nananek/rp2350-frisk/docs/pcb_bottom.png

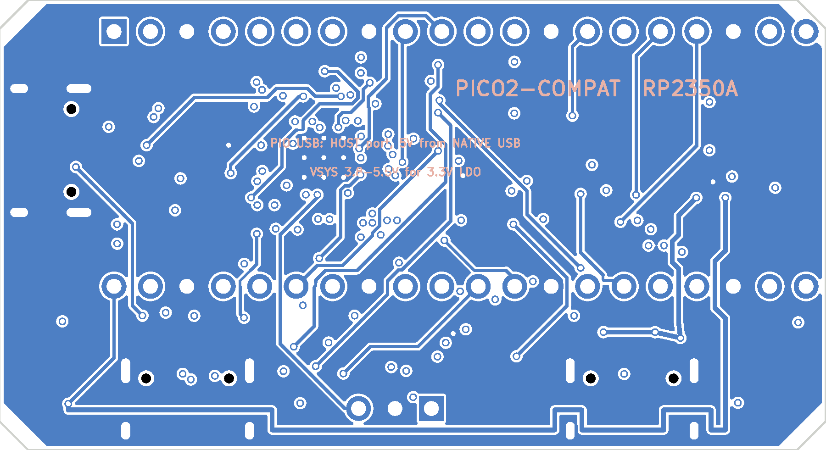
docs/pcb_bottom.png
