nananek/rp2350-frisk/docs/pcb_routing.png

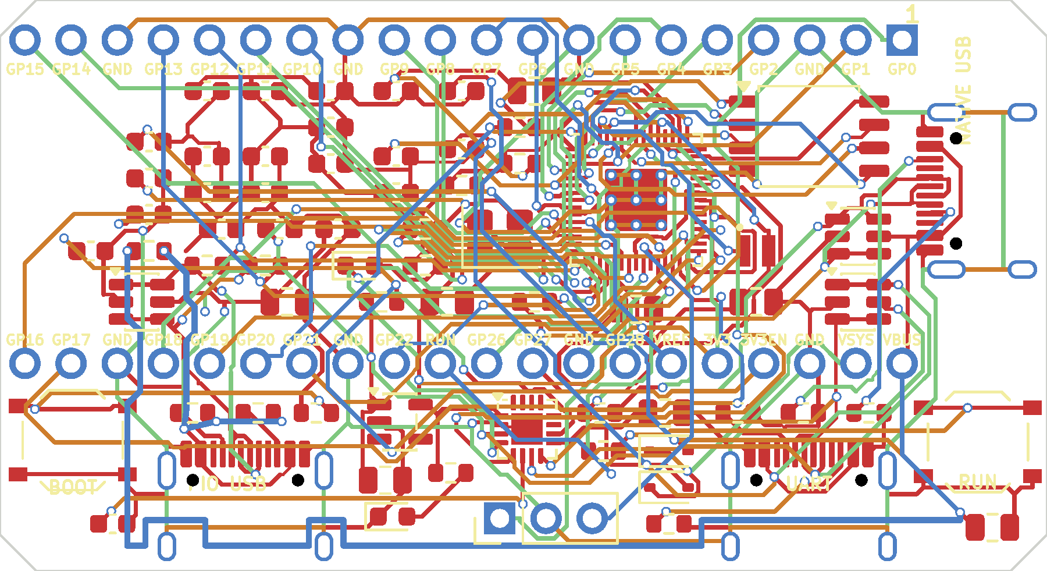
docs/pcb_routing.png
