nananek/rp2350-frisk/fab/bom_jlcpcb.csv

Comment | Designator | Footprint | LCSC Part #
RP2350A | U1 | RP2350-QFN-60-1EP_7x7_P0.4mm_EP3.4x3.4mm_ThermalVias | C42411118
W25Q32JVSSIQ | U2 | SOIC-8_5.3x5.3mm_P1.27mm | C179173
CH343P | U3 | QFN-16-1EP_3x3mm_P0.5mm_EP1.7x1.7mm | C2846043
AP2112K-3.3 | U4 | SOT-23-5 | C51118
TYPE-C-31-M-12 | J1,J2,J3 | USB_C_Receptacle_HRO_TYPE-C-31-M-12 | C165948
BAT54WS | D1,D3 | D_SOD-323 | C22629
USBLC6-2SC6 | D4,D5,D6 | SOT-23-6 | C7519
5.1k | R1,R2,R5,R6 | R_0603_1608Metric | C23186
56k | R3,R4 | R_0603_1608Metric | C23206
27 | R7,R8 | R_0603_1608Metric | C25190
22 | R9,R10 | R_0603_1608Metric | C23345
0 | R11,R14 | R_0603_1608Metric | C21189
1k | R12,R13,R18,R19,R20 | R_0603_1608Metric | C21190
33 | R15 | R_0603_1608Metric | C23140
200 | R16 | R_0603_1608Metric | C8218
100k | R17 | R_0603_1608Metric | C14675
3.3uH | L1 | L_pol_2016 | C42411119
ABM8-272-T3 | Y1 | Crystal_SMD_3225-4Pin_3.2x2.5mm | C20625731
BOOT | SW1 | SW_Push_1P1T_XKB_TS-1187A | C318884
RUN | SW2 | SW_Push_1P1T_XKB_TS-1187A | C318884
KT-0603R | LED1,LED2 | LED_0603_1608Metric | C2286
10uF | C1,C2,C3,C7,C9 | C_0805_2012Metric | C15850
100nF | C4,C5,C6,C8,C10,C12,C14,C15,C16,C17,C18,C19,C20,C21,C22,C23,C24,C27,C28,C29 | C_0603_1608Metric | C14663
4.7uF | C11,C13,C30 | C_0805_2012Metric | C1779
15pF | C25,C26 | C_0603_1608Metric | C1644
