nananek/rp2350-frisk/docs/schematic.pdf

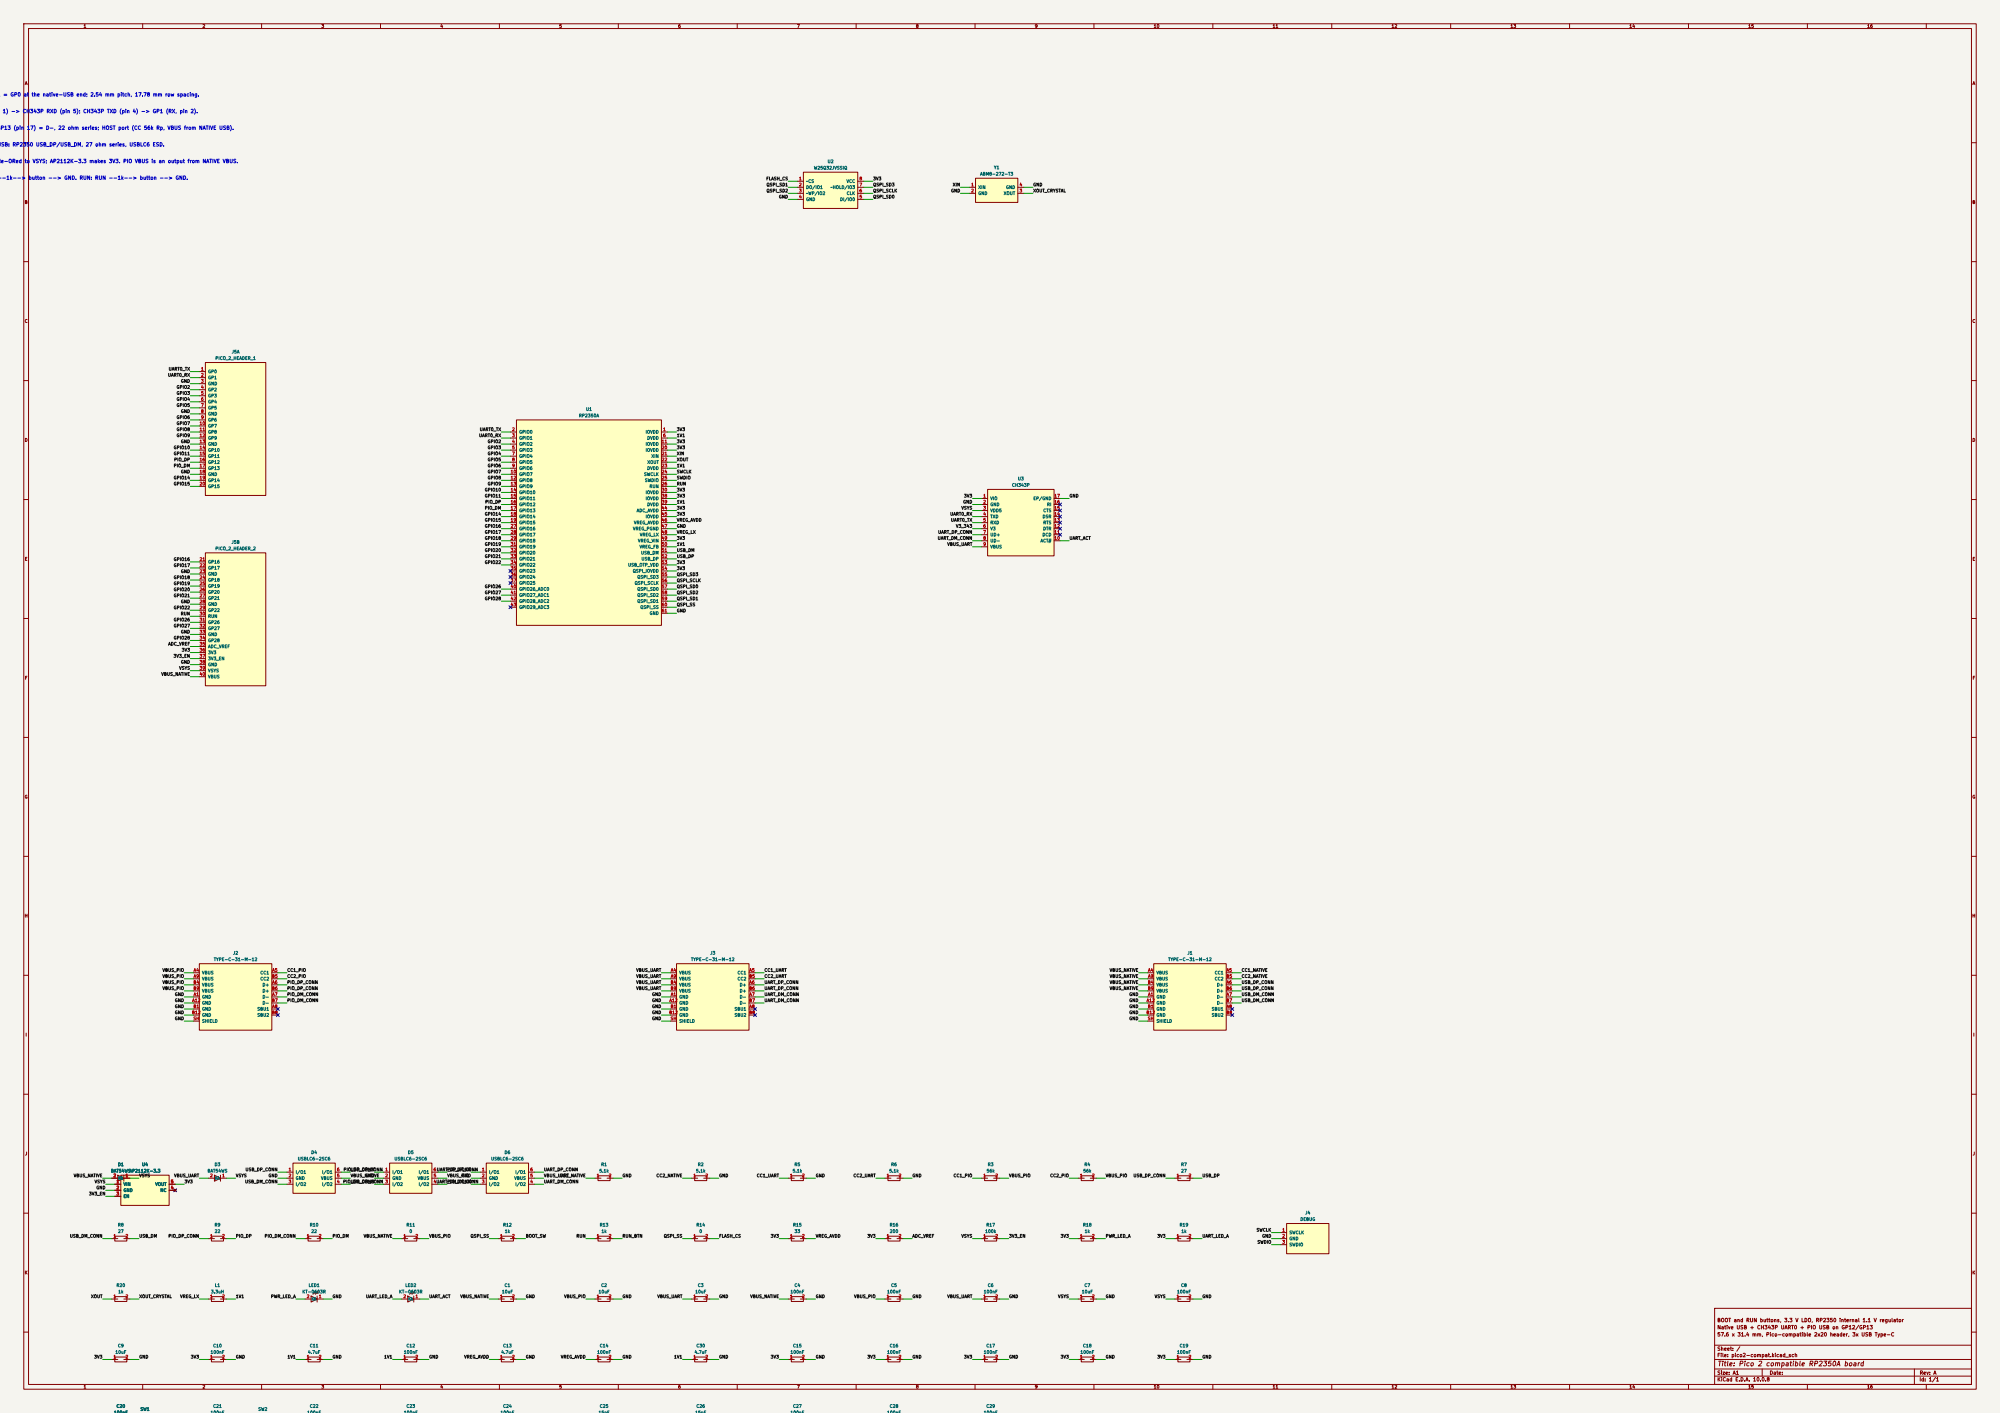
[picture p4: page 1]

Pico 2 header: pin 1 = GP0 at the native-USB end; 2.54 mm pitch, 17.78 mm row spacing.

UART0: GP0 (TX, pin 1) -> CH343P RXD (pin 5); CH343P TXD (pin 4) -> GP1 (RX, pin 2).

PIO USB: GP12 (pin 16) = D+, GP13 (pin 17) = D-, 22 ohm series; HOST port (CC 56k Rp, VBUS from NATIVE USB).

Native USB: RP2350 USB_DP/USB_DM, 27 ohm series, USBLC6 ESD.

Power: NATIVE/UART VBUS are diode-ORed to VSYS; AP2112K-3.3 makes 3V3. PIO VBUS is an output from NATIVE VBUS.

BOOT: QSPI_SS --1k--> button --> GND. RUN: RUN --1k--> button --> GND.

Native USB + CH343P UART0 + PIO USB on GP12/GP13
57.6 x 31.4 mm, Pico-compatible 2x20 header, 3x USB Type-C

Sheet: /
File: pico2-compat.kicad_sch
Title: Pico 2 compatible RP2350A board

Size: A1 | Rev: A
KiCad E.D.A. 10.0.8 | Id: 1/1
