nananek/rp2350-frisk/pico2-compat.kicad_pcb

## KiCad design pico2-compat.kicad_pcb (2026-11-09)

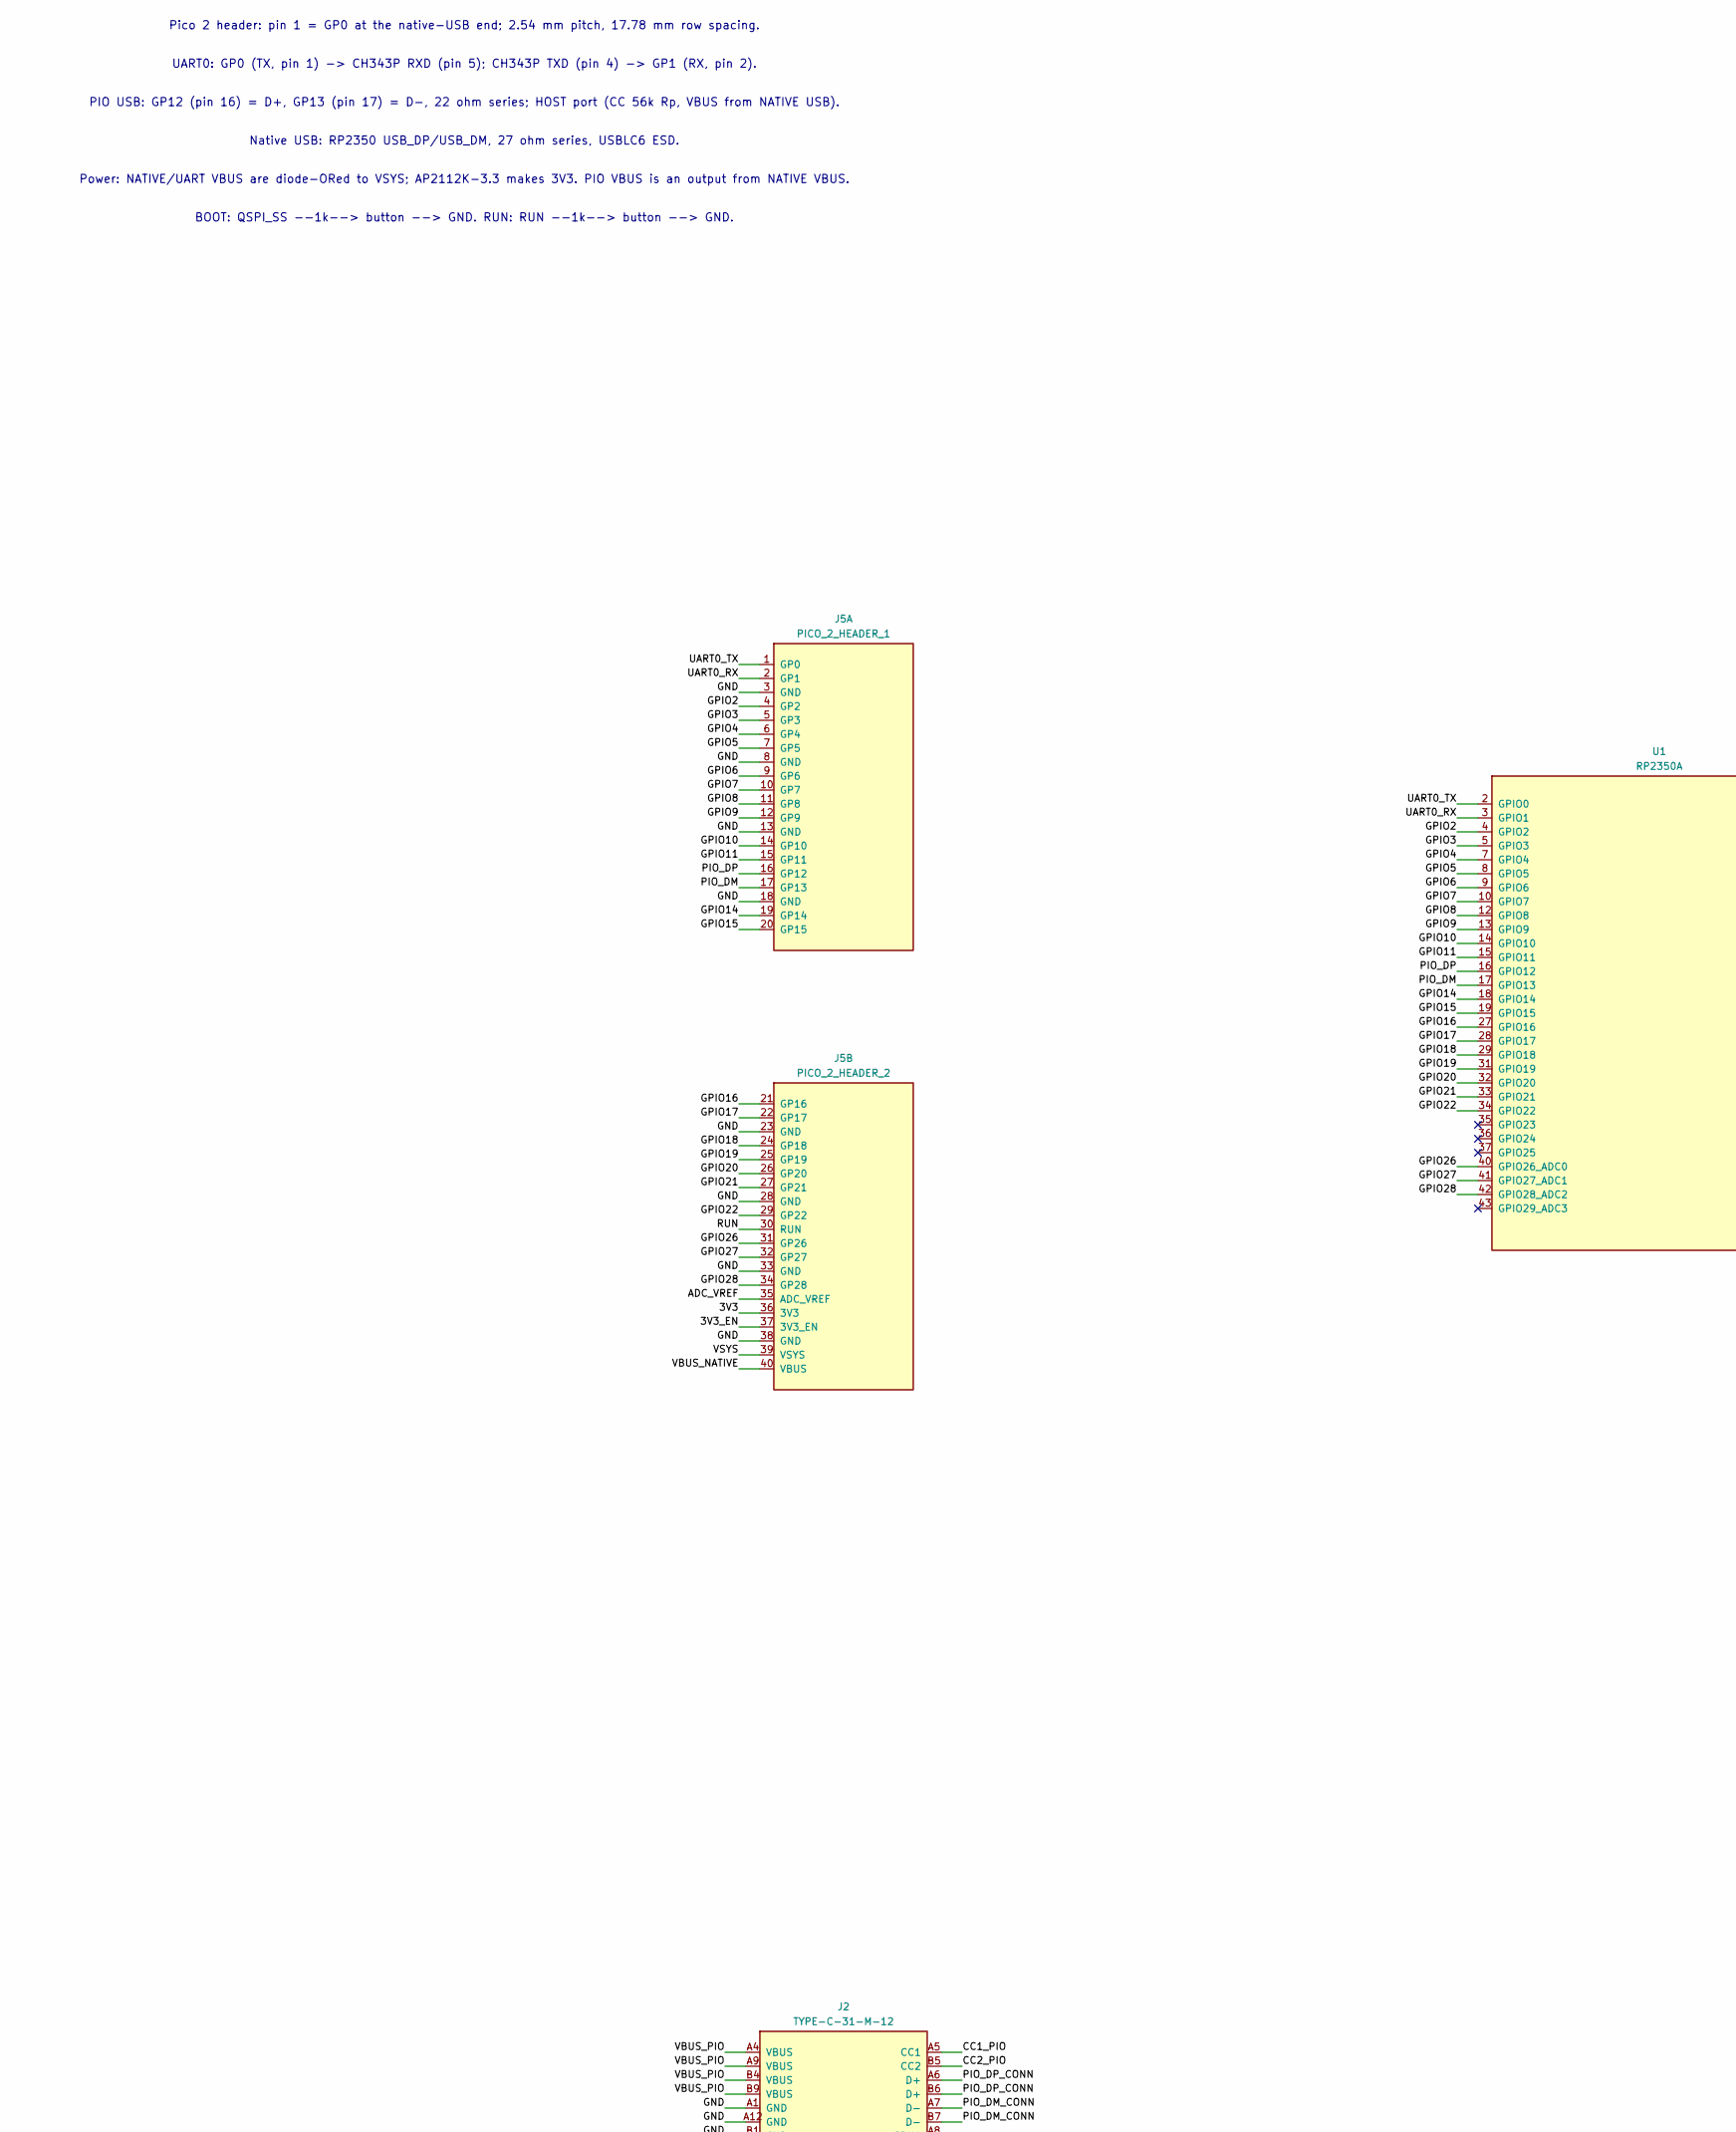
[picture p5: schematic pico2-compat.kicad_sch, Pico 2 compatible RP2350A board, part in row 1, column 1]

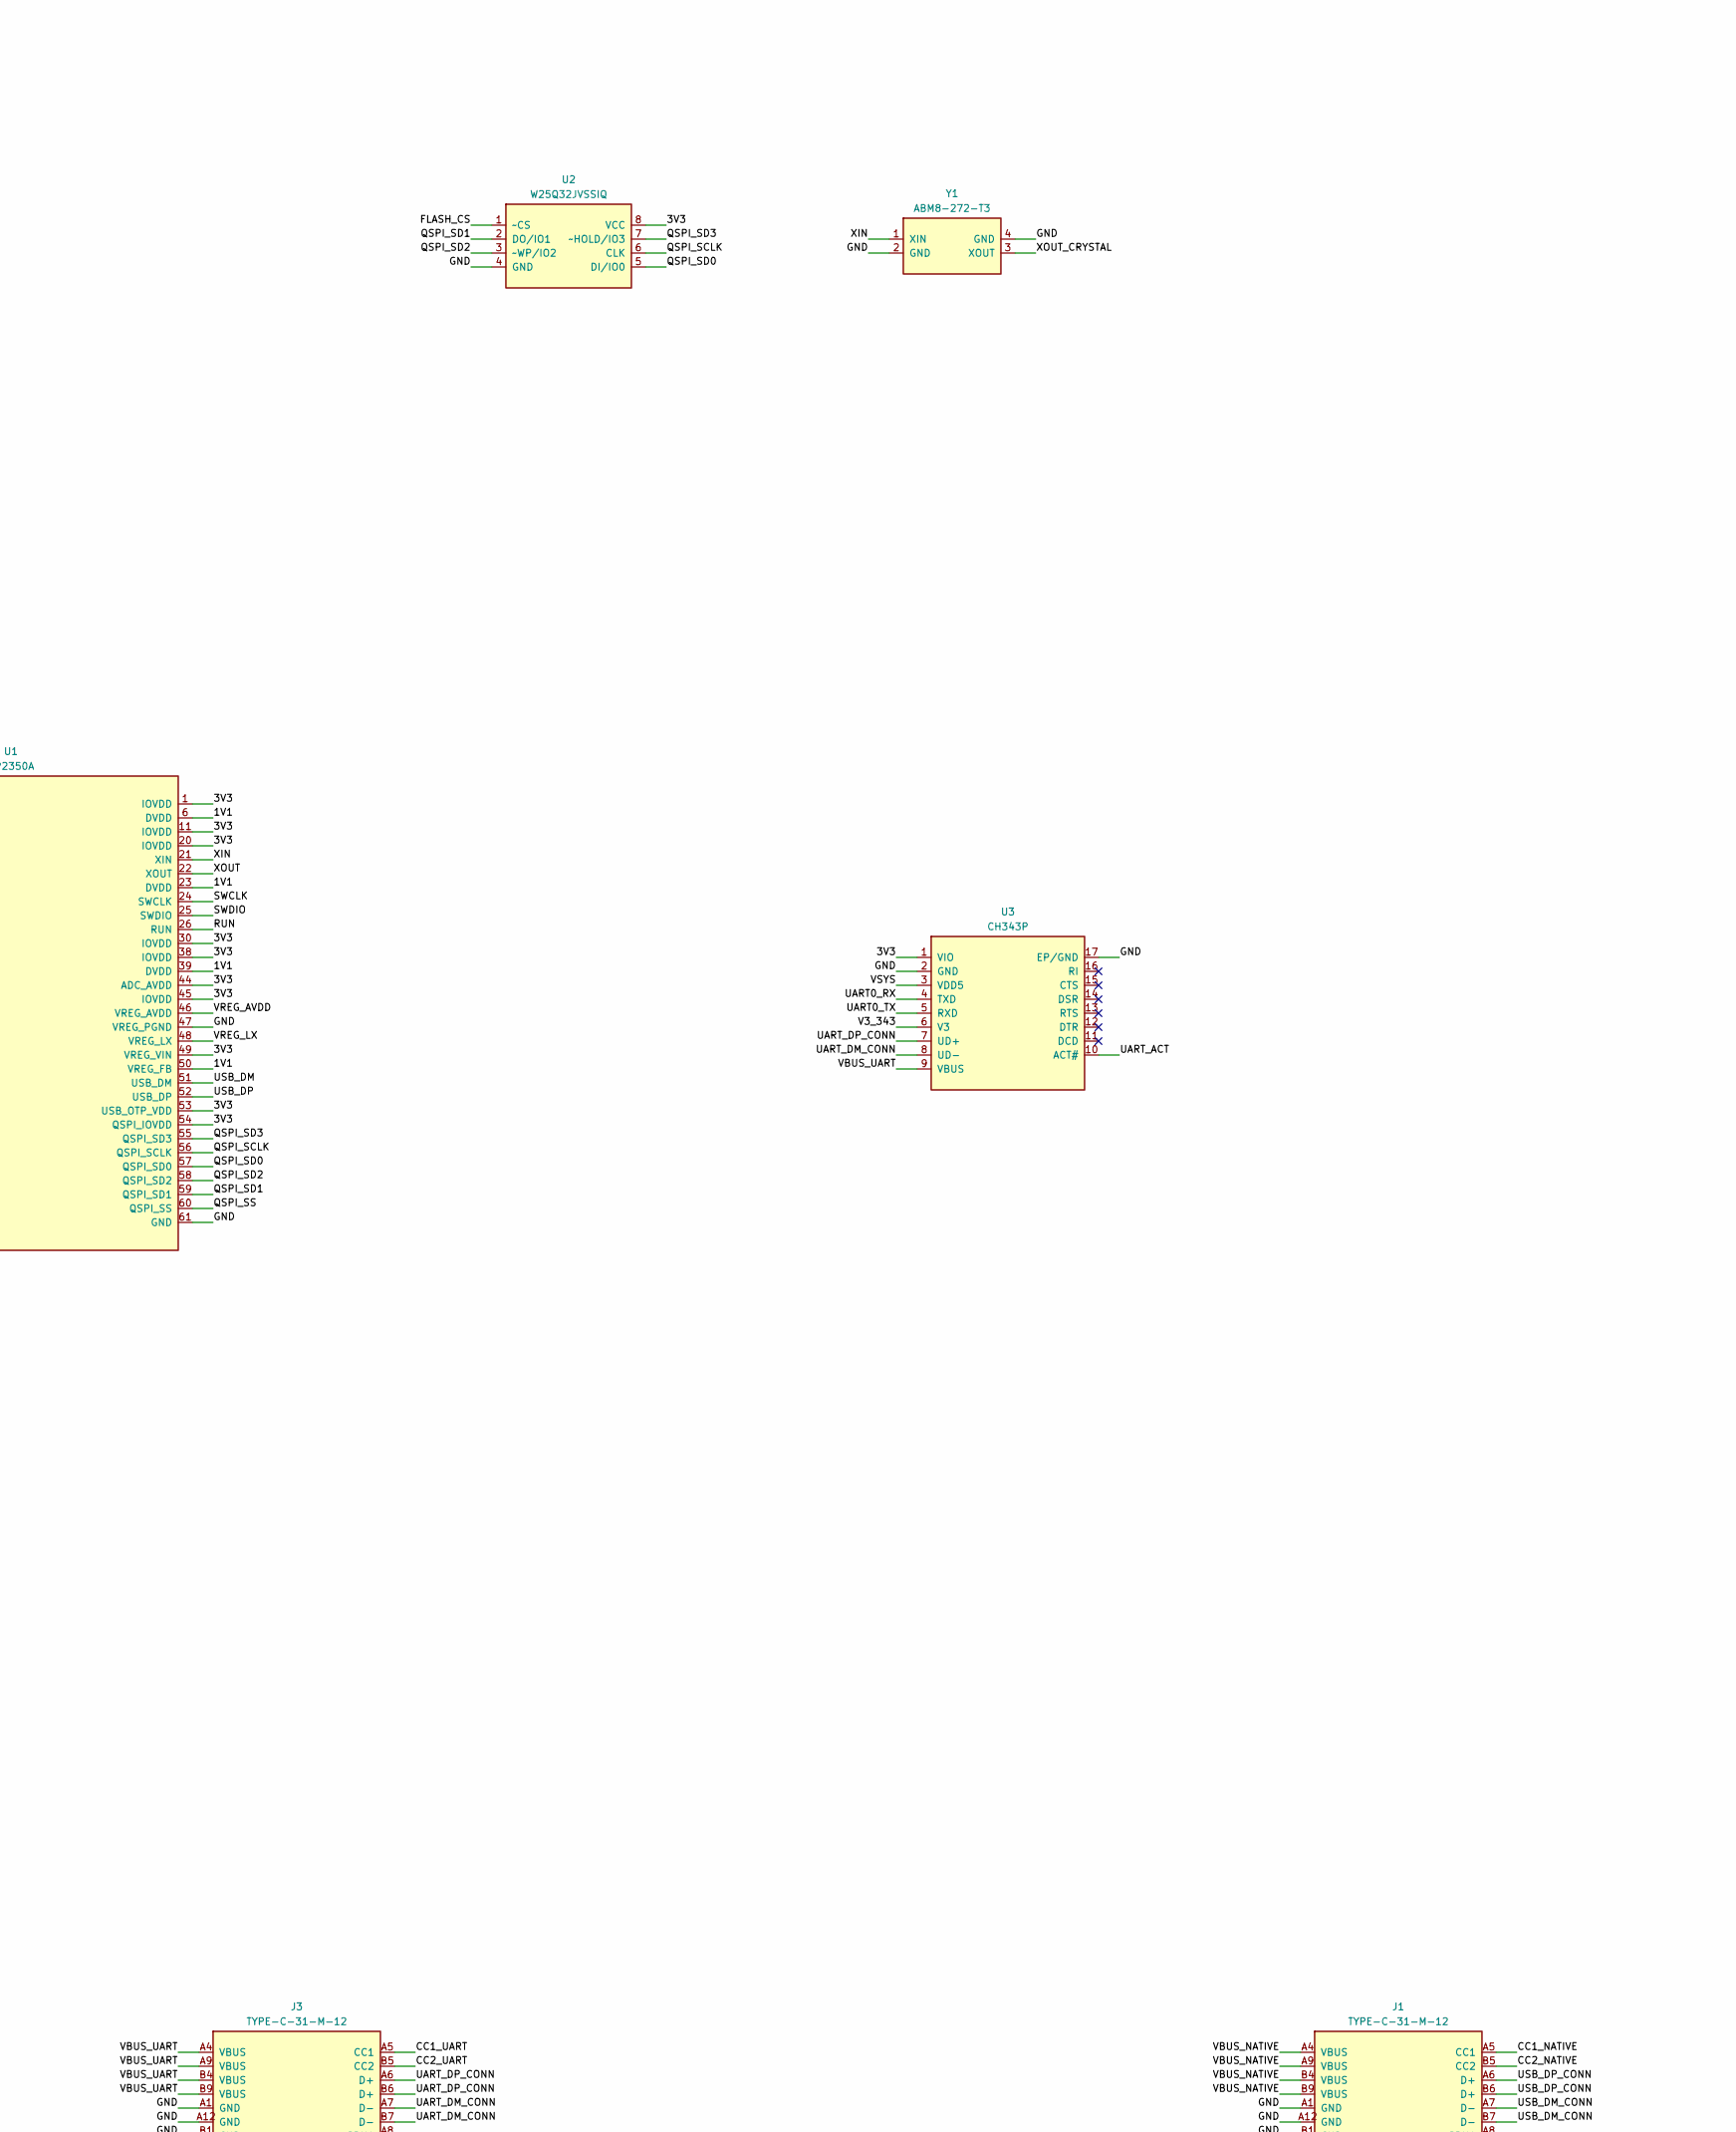
[picture p6: schematic pico2-compat.kicad_sch, Pico 2 compatible RP2350A board, part in row 1, column 2]

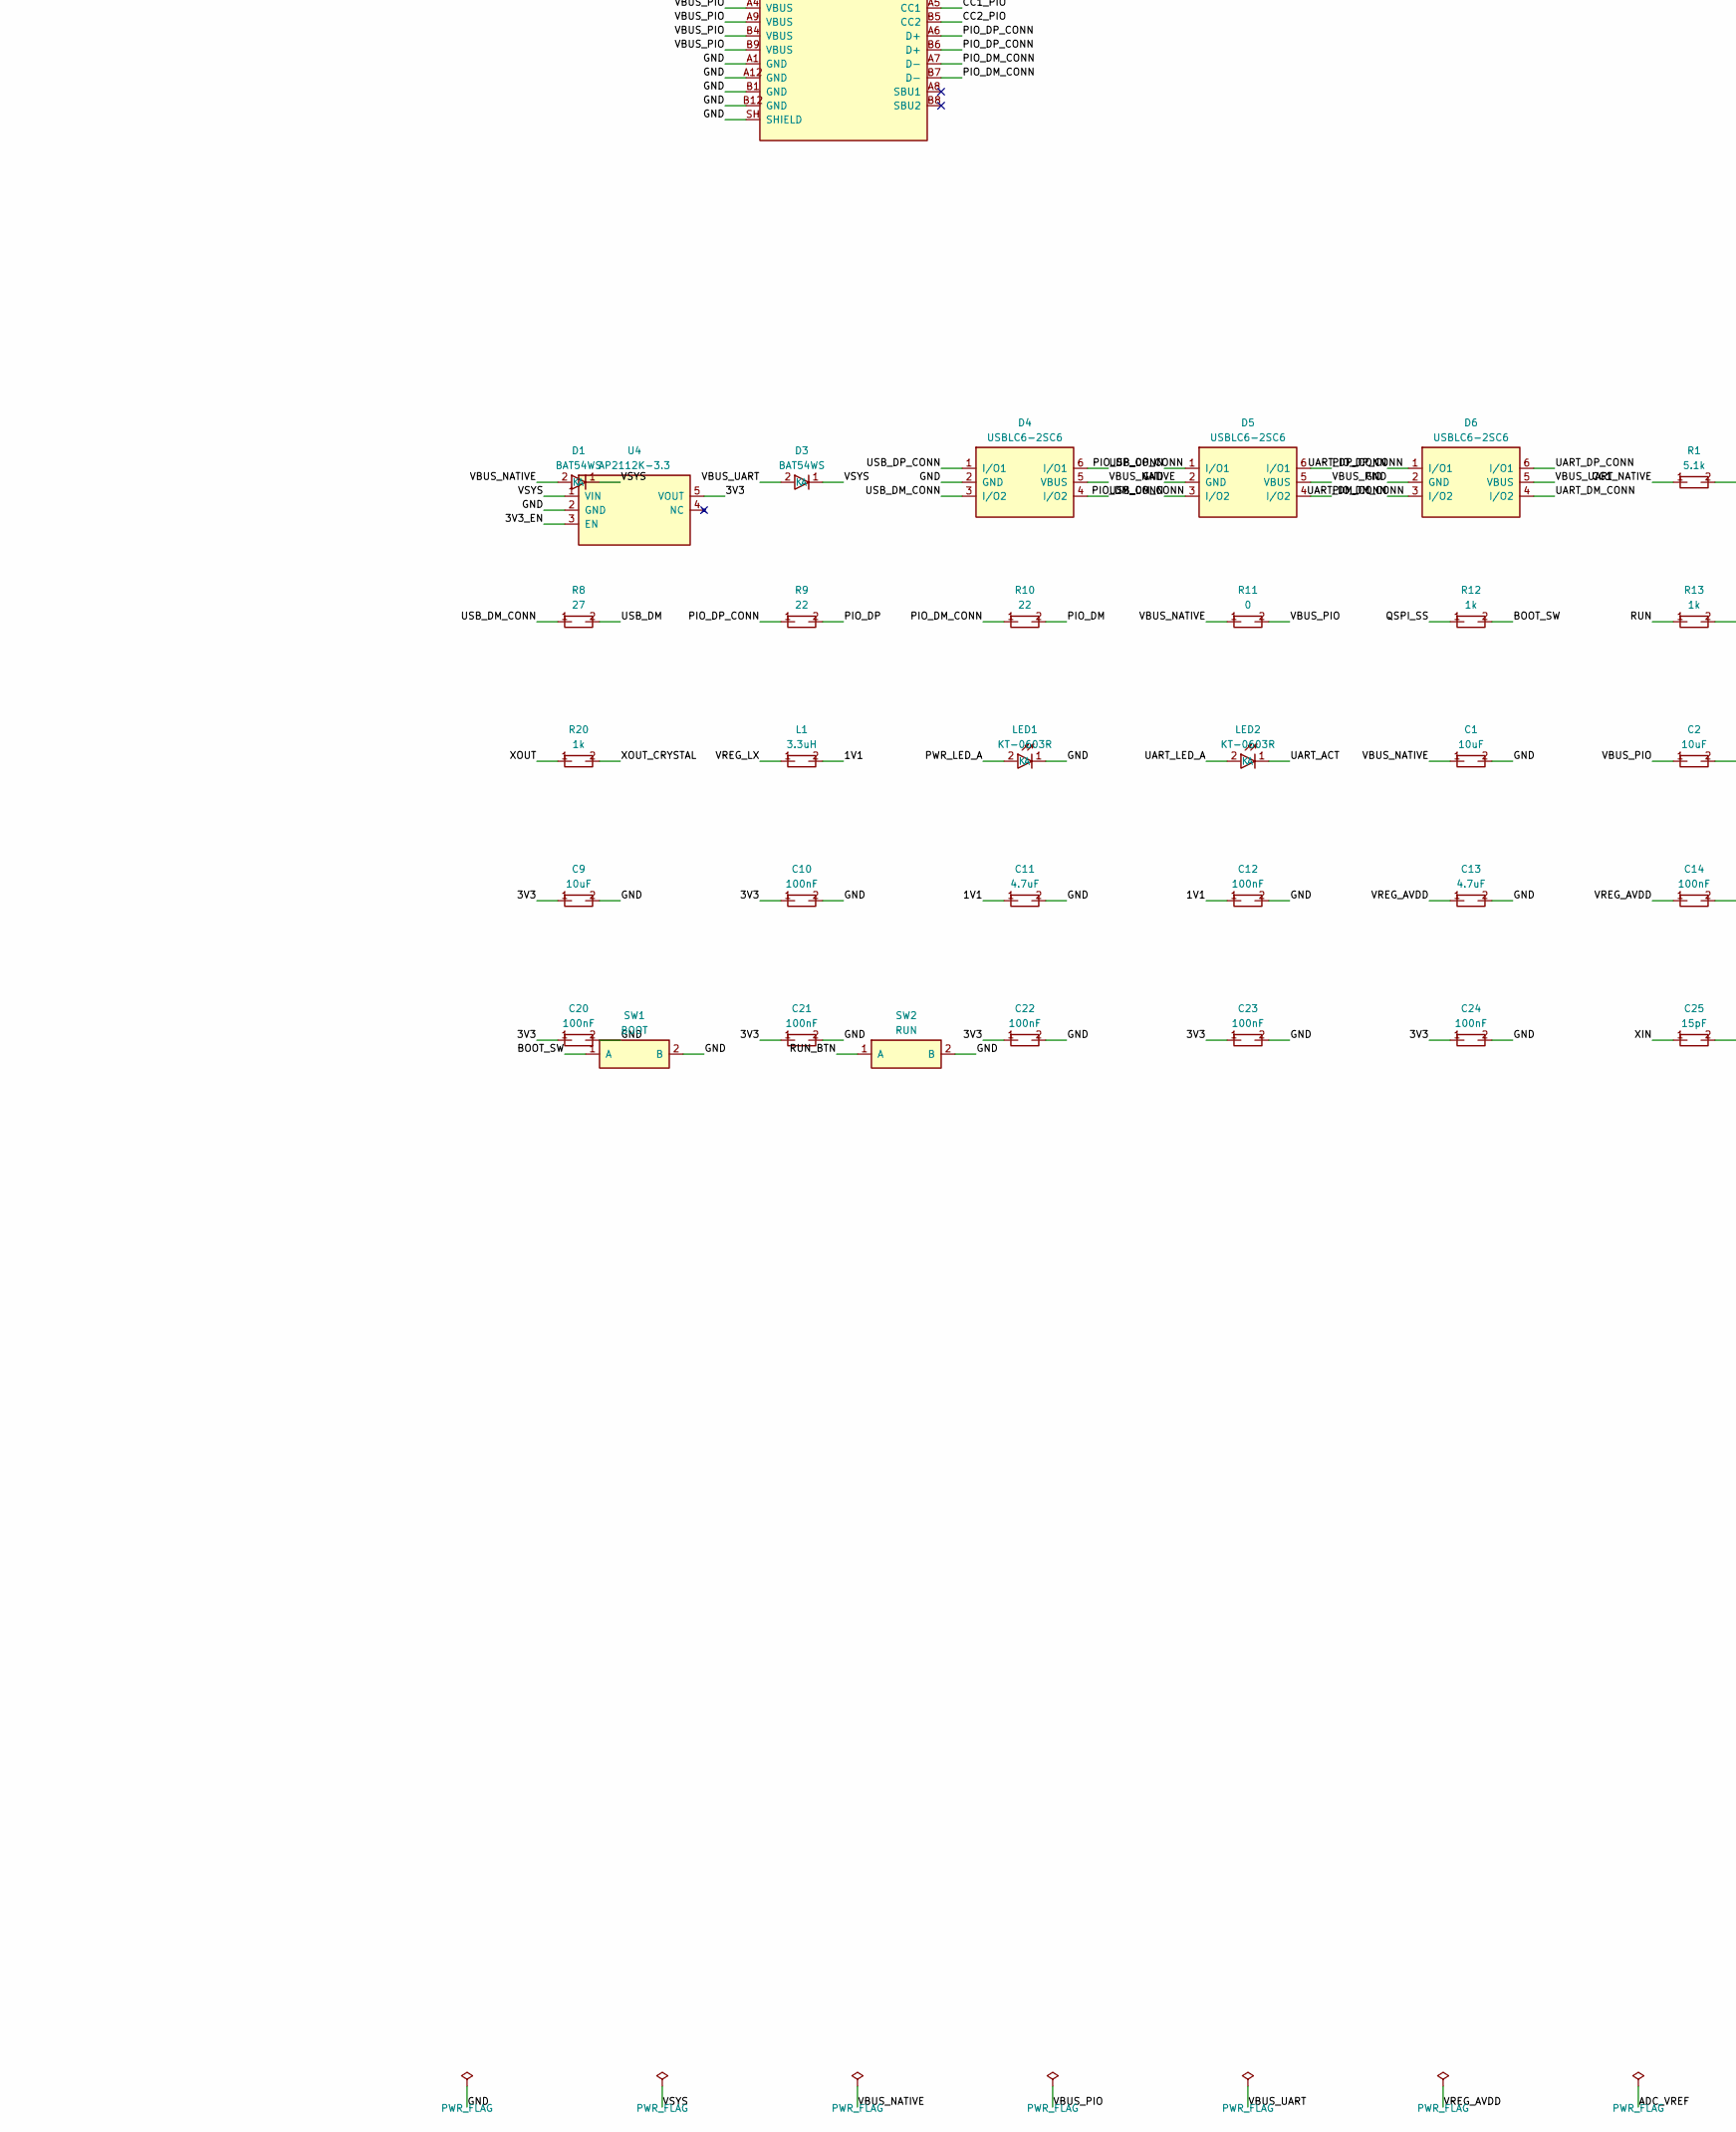
[picture p7: schematic pico2-compat.kicad_sch, Pico 2 compatible RP2350A board, part in row 2, column 1]

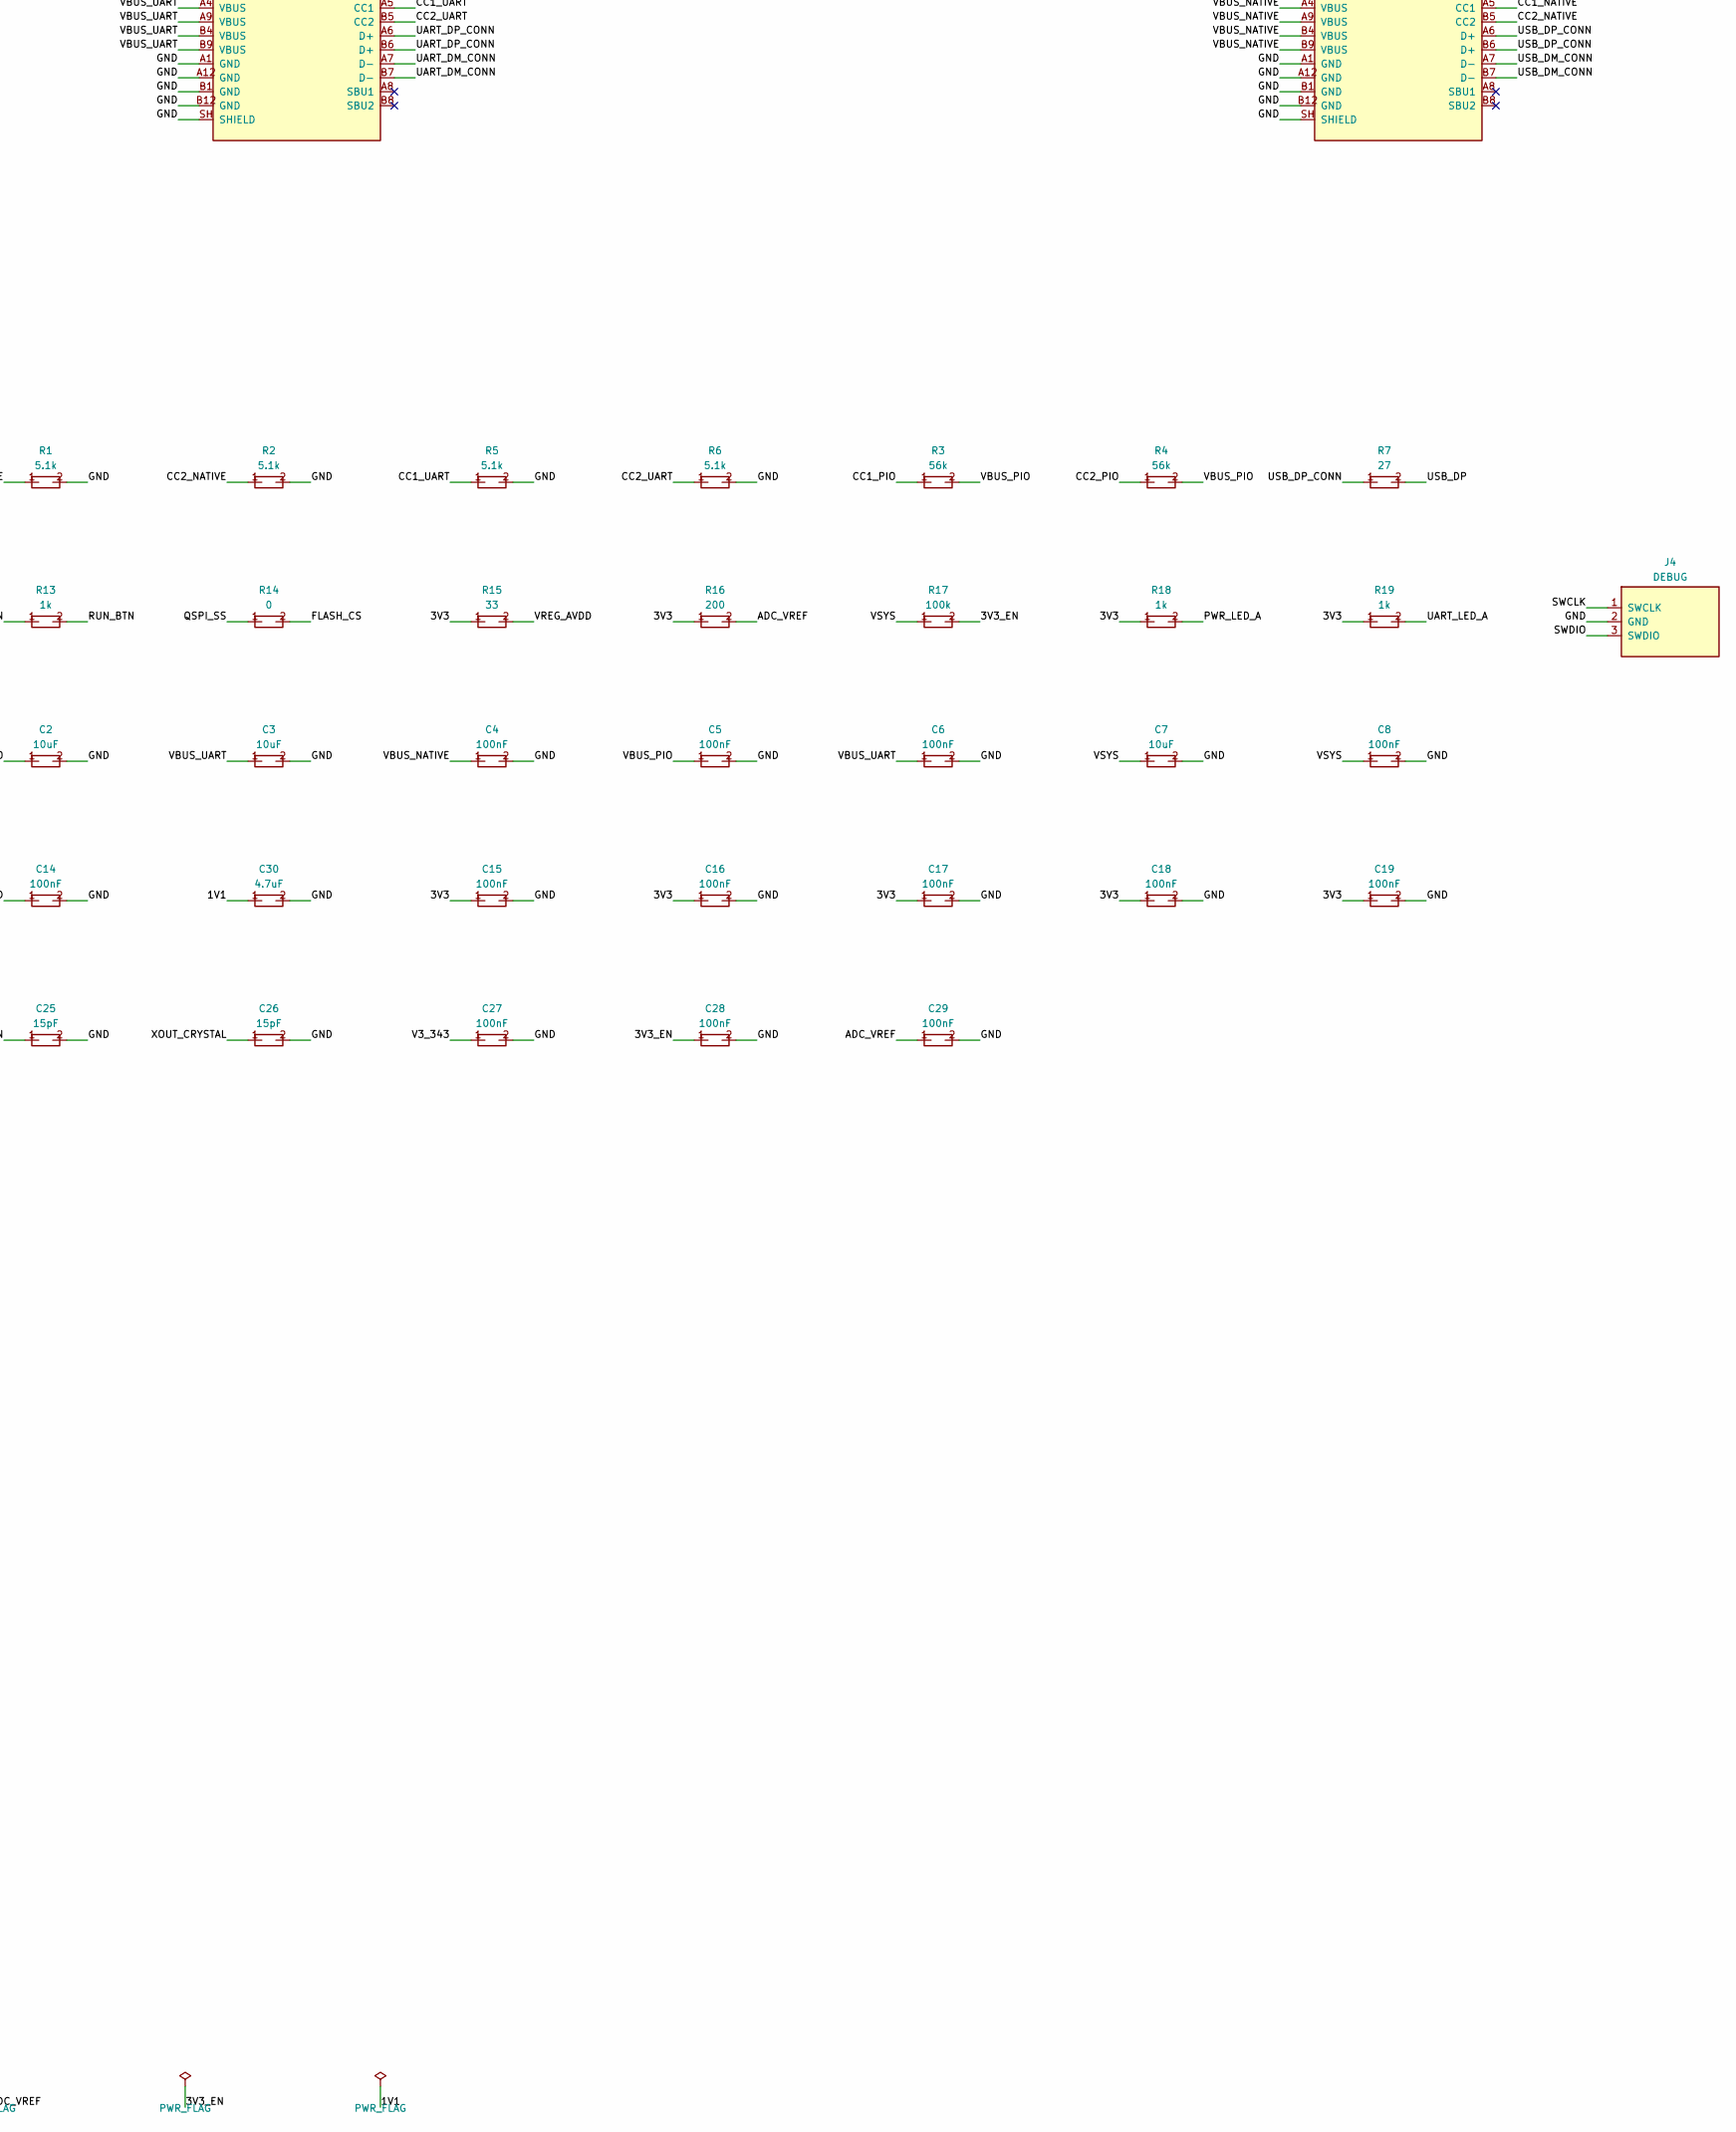
[picture p8: schematic pico2-compat.kicad_sch, Pico 2 compatible RP2350A board, part in row 2, column 2]

Parts:
C1, C2, C3, C7, C9: 10uF; C_0805_2012Metric; LCSC C15850
C4, C5, C6, C8, C10, C12, C14, C15, C16, C17, C18, C19, C20, C21, C22, C23, C24, C27, C28, C29: 100nF; C_0603_1608Metric; LCSC C14663
C11, C13, C30: 4.7uF; C_0805_2012Metric; LCSC C1779
C25, C26: 15pF; C_0603_1608Metric; LCSC C1644
D1, D3: BAT54WS; D_SOD-323; LCSC C22629
D4, D5, D6: USBLC6-2SC6; SOT-23-6; LCSC C7519
J1, J2, J3: TYPE-C-31-M-12; USB_C_Receptacle_HRO_TYPE-C-31-M-12; LCSC C165948
J4: DEBUG; PinHeader_1x03_P2.54mm_Vertical
J5A: PICO_2_HEADER_1; PinHeader_1x20_Pico_Top
J5B: PICO_2_HEADER_2; PinHeader_1x20_Pico_Bottom
L1: 3.3uH; L_pol_2016; LCSC C42411119
LED1, LED2: KT-0603R; LED_0603_1608Metric; LCSC C2286
R1, R2, R5, R6: 5.1k; R_0603_1608Metric; LCSC C23186
R3, R4: 56k; R_0603_1608Metric; LCSC C23206
R7, R8: 27; R_0603_1608Metric; LCSC C25190
R9, R10: 22; R_0603_1608Metric; LCSC C23345
R11, R14: 0; R_0603_1608Metric; LCSC C21189
R12, R13, R18, R19, R20: 1k; R_0603_1608Metric; LCSC C21190
R15: 33; R_0603_1608Metric; LCSC C23140
R16: 200; R_0603_1608Metric; LCSC C8218
R17: 100k; R_0603_1608Metric; LCSC C14675
SW1: BOOT; SW_Push_1P1T_XKB_TS-1187A; LCSC C318884
SW2: RUN; SW_Push_1P1T_XKB_TS-1187A; LCSC C318884
U1: RP2350A; RP2350-QFN-60-1EP_7x7_P0.4mm_EP3.4x3.4mm_ThermalVias; LCSC C42411118
U2: W25Q32JVSSIQ; SOIC-8_5.3x5.3mm_P1.27mm; LCSC C179173
U3: CH343P; QFN-16-1EP_3x3mm_P0.5mm_EP1.7x1.7mm; LCSC C2846043
U4: AP2112K-3.3; SOT-23-5; LCSC C51118
Y1: ABM8-272-T3; Crystal_SMD_3225-4Pin_3.2x2.5mm; LCSC C20625731

Connections:
1V1: C11.1, C12.1, C30.1, L1.2, U1.6 (DVDD), U1.23 (DVDD), U1.39 (DVDD), U1.50 (VREG_FB)
3V3: C9.1, C10.1, C15.1, C16.1, C17.1, C18.1, C19.1, C20.1, C21.1, C22.1, C23.1, C24.1, J5B.36 (3V3), R15.1, R16.1, R18.1, R19.1, U1.1 (IOVDD), U1.11 (IOVDD), U1.20 (IOVDD), U1.30 (IOVDD), U1.38 (IOVDD), U1.44 (ADC_AVDD), U1.45 (IOVDD), U1.49 (VREG_VIN), U1.53 (USB_OTP_VDD), U1.54 (QSPI_IOVDD), U2.8 (VCC), U3.1 (VIO), U4.5 (VOUT)
3V3_EN: C28.1, J5B.37 (3V3_EN), R17.2, U4.3 (EN)
ADC_VREF: C29.1, J5B.35 (ADC_VREF), R16.2
BOOT_SW: R12.2, SW1.1 (A)
CC1_NATIVE: J1.A5 (CC1), R1.1
CC1_PIO: J2.A5 (CC1), R3.1
CC1_UART: J3.A5 (CC1), R5.1
CC2_NATIVE: J1.B5 (CC2), R2.1
CC2_PIO: J2.B5 (CC2), R4.1
CC2_UART: J3.B5 (CC2), R6.1
FLASH_CS: R14.2, U2.1 (~CS)
GND: C1.2, C2.2, C3.2, C4.2, C5.2, C6.2, C7.2, C8.2, C9.2, C10.2, C11.2, C12.2, C13.2, C14.2, C15.2, C16.2, C17.2, C18.2, C19.2, C20.2, C21.2, C22.2, C23.2, C24.2, C25.2, C26.2, C27.2, C28.2, C29.2, C30.2, D4.2 (GND), D5.2 (GND), D6.2 (GND), J1.A1 (GND), J1.A12 (GND), J1.B1 (GND), J1.B12 (GND), J1.SH (SHIELD), J2.A1 (GND), J2.A12 (GND), J2.B1 (GND), J2.B12 (GND), J2.SH (SHIELD), J3.A1 (GND), J3.A12 (GND), J3.B1 (GND), J3.B12 (GND), J3.SH (SHIELD), J4.2 (GND), J5A.3 (GND), J5A.8 (GND), J5A.13 (GND), J5A.18 (GND), J5B.23 (GND), J5B.28 (GND), J5B.33 (GND), J5B.38 (GND), LED1.1 (K), R1.2, R2.2, R5.2, R6.2, SW1.2 (B), SW2.2 (B), U1.47 (VREG_PGND), U1.61 (GND), U2.4 (GND), U3.2 (GND), U3.17 (EP/GND), U4.2 (GND), Y1.2 (GND), Y1.4 (GND)
GPIO2: J5A.4 (GP2), U1.4 (GPIO2)
GPIO3: J5A.5 (GP3), U1.5 (GPIO3)
GPIO4: J5A.6 (GP4), U1.7 (GPIO4)
GPIO5: J5A.7 (GP5), U1.8 (GPIO5)
GPIO6: J5A.9 (GP6), U1.9 (GPIO6)
GPIO7: J5A.10 (GP7), U1.10 (GPIO7)
GPIO8: J5A.11 (GP8), U1.12 (GPIO8)
GPIO9: J5A.12 (GP9), U1.13 (GPIO9)
GPIO10: J5A.14 (GP10), U1.14 (GPIO10)
GPIO11: J5A.15 (GP11), U1.15 (GPIO11)
GPIO14: J5A.19 (GP14), U1.18 (GPIO14)
GPIO15: J5A.20 (GP15), U1.19 (GPIO15)
GPIO16: J5B.21 (GP16), U1.27 (GPIO16)
GPIO17: J5B.22 (GP17), U1.28 (GPIO17)
GPIO18: J5B.24 (GP18), U1.29 (GPIO18)
GPIO19: J5B.25 (GP19), U1.31 (GPIO19)
GPIO20: J5B.26 (GP20), U1.32 (GPIO20)
GPIO21: J5B.27 (GP21), U1.33 (GPIO21)
GPIO22: J5B.29 (GP22), U1.34 (GPIO22)
GPIO26: J5B.31 (GP26), U1.40 (GPIO26_ADC0)
GPIO27: J5B.32 (GP27), U1.41 (GPIO27_ADC1)
GPIO28: J5B.34 (GP28), U1.42 (GPIO28_ADC2)
PIO_DM: J5A.17 (GP13), R10.2, U1.17 (GPIO13)
PIO_DM_CONN: D5.3 (I/O2), D5.4 (I/O2), J2.A7 (D-), J2.B7 (D-), R10.1
PIO_DP: J5A.16 (GP12), R9.2, U1.16 (GPIO12)
PIO_DP_CONN: D5.1 (I/O1), D5.6 (I/O1), J2.A6 (D+), J2.B6 (D+), R9.1
PWR_LED_A: LED1.2 (A), R18.2
QSPI_SCLK: U1.56 (QSPI_SCLK), U2.6 (CLK)
QSPI_SD0: U1.57 (QSPI_SD0), U2.5 (DI/IO0)
QSPI_SD1: U1.59 (QSPI_SD1), U2.2 (DO/IO1)
QSPI_SD2: U1.58 (QSPI_SD2), U2.3 (~WP/IO2)
QSPI_SD3: U1.55 (QSPI_SD3), U2.7 (~HOLD/IO3)
QSPI_SS: R12.1, R14.1, U1.60 (QSPI_SS)
RUN: J5B.30 (RUN), R13.1, U1.26 (RUN)
RUN_BTN: R13.2, SW2.1 (A)
SWCLK: J4.1 (SWCLK), U1.24 (SWCLK)
SWDIO: J4.3 (SWDIO), U1.25 (SWDIO)
UART0_RX: J5A.2 (GP1), U1.3 (GPIO1), U3.4 (TXD)
UART0_TX: J5A.1 (GP0), U1.2 (GPIO0), U3.5 (RXD)
UART_ACT: LED2.1 (K), U3.10 (ACT#)
UART_DM_CONN: D6.3 (I/O2), D6.4 (I/O2), J3.A7 (D-), J3.B7 (D-), U3.8 (UD-)
UART_DP_CONN: D6.1 (I/O1), D6.6 (I/O1), J3.A6 (D+), J3.B6 (D+), U3.7 (UD+)
UART_LED_A: LED2.2 (A), R19.2
USB_DM: R8.2, U1.51 (USB_DM)
USB_DM_CONN: D4.3 (I/O2), D4.4 (I/O2), J1.A7 (D-), J1.B7 (D-), R8.1
USB_DP: R7.2, U1.52 (USB_DP)
USB_DP_CONN: D4.1 (I/O1), D4.6 (I/O1), J1.A6 (D+), J1.B6 (D+), R7.1
V3_343: C27.1, U3.6 (V3)
VBUS_NATIVE: C1.1, C4.1, D1.2 (A), D4.5 (VBUS), J1.A4 (VBUS), J1.A9 (VBUS), J1.B4 (VBUS), J1.B9 (VBUS), J5B.40 (VBUS), R11.1
VBUS_PIO: C2.1, C5.1, D5.5 (VBUS), J2.A4 (VBUS), J2.A9 (VBUS), J2.B4 (VBUS), J2.B9 (VBUS), R3.2, R4.2, R11.2
VBUS_UART: C3.1, C6.1, D3.2 (A), D6.5 (VBUS), J3.A4 (VBUS), J3.A9 (VBUS), J3.B4 (VBUS), J3.B9 (VBUS), U3.9 (VBUS)
VREG_AVDD: C13.1, C14.1, R15.2, U1.46 (VREG_AVDD)
VREG_LX: L1.1, U1.48 (VREG_LX)
VSYS: C7.1, C8.1, D1.1 (K), D3.1 (K), J5B.39 (VSYS), R17.1, U3.3 (VDD5), U4.1 (VIN)
XIN: C25.1, U1.21 (XIN), Y1.1 (XIN)
XOUT: R20.1, U1.22 (XOUT)
XOUT_CRYSTAL: C26.1, R20.2, Y1.3 (XOUT)

Notes on the sheet:
Pico 2 header: pin 1 = GP0 at the native-USB end; 2.54 mm pitch, 17.78 mm row spacing.
UART0: GP0 (TX, pin 1) -> CH343P RXD (pin 5); CH343P TXD (pin 4) -> GP1 (RX, pin 2).
PIO USB: GP12 (pin 16) = D+, GP13 (pin 17) = D-, 22 ohm series; HOST port (CC 56k Rp, VBUS from NATIVE USB).
Native USB: RP2350 USB_DP/USB_DM, 27 ohm series, USBLC6 ESD.
Power: NATIVE/UART VBUS are diode-ORed to VSYS; AP2112K-3.3 makes 3V3. PIO VBUS is an output from NATIVE VBUS.
BOOT: QSPI_SS --1k--> button --> GND. RUN: RUN --1k--> button --> GND.

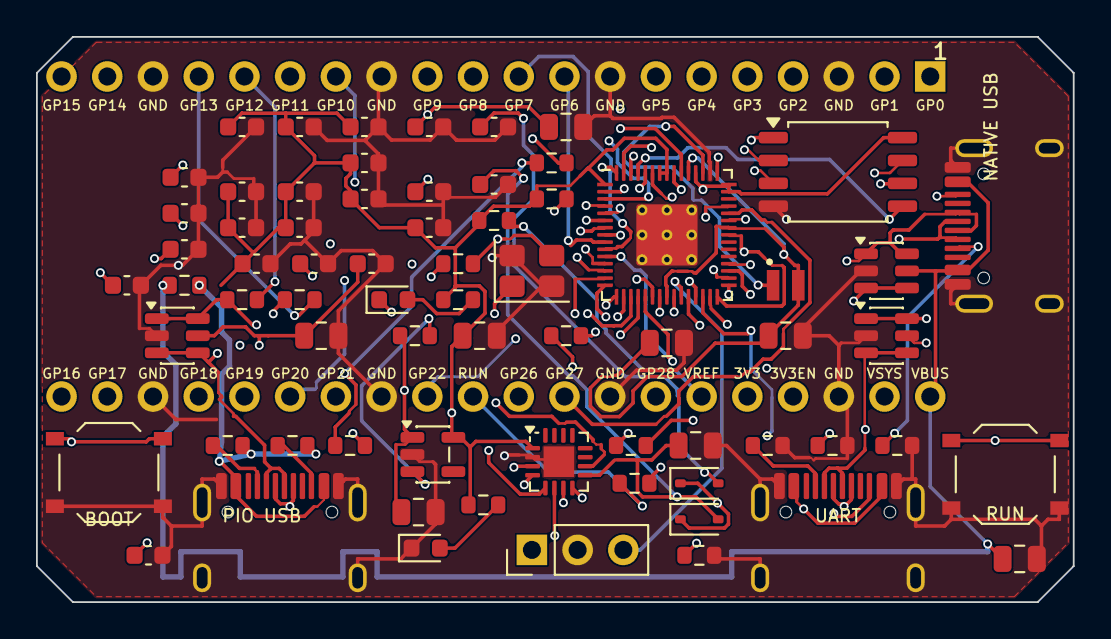
[picture p9: board pico2-compat.kicad_pcb from above]

Board: 4 copper layers, 57.6 x 31.4 mm, 71 parts (0 on the bottom side), 70 nets.
