nananek/rp2350-frisk/scripts/make_jlc_files.py

"""Create JLCPCB-format BOM / CPL from design.py and the KiCad placement file."""

import csv
import math
import os
import sys
from collections import OrderedDict

sys.path.insert(0, os.path.dirname(os.path.abspath(__file__)))
from design import PARTS  # noqa: E402

ROOT = os.path.dirname(os.path.dirname(os.path.abspath(__file__)))
FAB = os.path.join(ROOT, "fab")

# JLCPCB rotation corrections.  These are the usual KiCad -> JLC offsets for
# the packages used here.  Always check the JLC placement preview before
# ordering; the preview is the final authority.
USB_C_FOOTPRINT = "USB_C_Receptacle_HRO_TYPE-C-31-M-12"
USB_C_POSITION_OFFSET = 1.571

ROTATION_OFFSETS = (
    ("SOIC-8_5.3x5.3mm_P1.27mm", 270),
    ("SOT-23-5", 270),
    ("SOT-23-6", 270),
    ("SO-8", 270),
    ("SO-16", 270),
)


def rotation_offset(footprint):
    for prefix, offset in ROTATION_OFFSETS:
        if footprint.startswith(prefix):
            return offset
    return 0


def position_offset(footprint, rotation):
    if footprint != USB_C_FOOTPRINT:
        return 0.0, 0.0
    rad = math.radians(rotation)
    return (-USB_C_POSITION_OFFSET * math.sin(rad),
            USB_C_POSITION_OFFSET * math.cos(rad))


def clean_fp(fp):
    return fp.split(":", 1)[-1]


def write_bom():
    groups = OrderedDict()
    for part in PARTS:
        if not part.get("fitted", True):
            continue
        key = (part["value"], clean_fp(part["fp"]), part["lcsc"])
        groups.setdefault(key, []).append(part["ref"])
    path = os.path.join(FAB, "bom_jlcpcb.csv")
    with open(path, "w", newline="") as f:
        w = csv.writer(f)
        w.writerow(["Comment", "Designator", "Footprint", "LCSC Part #"])
        for (value, fp, lcsc), refs in groups.items():
            w.writerow([value, ",".join(refs), fp, lcsc])
    print("wrote", path)


def write_cpl():
    src = os.path.join(FAB, "pos_kicad.csv")
    out = os.path.join(FAB, "cpl_jlcpcb.csv")
    fitted = {part["ref"] for part in PARTS if part.get("fitted", True)}
    with open(src, newline="") as fi, open(out, "w", newline="") as fo:
        r = csv.DictReader(fi)
        w = csv.writer(fo)
        w.writerow(["Designator", "Mid X", "Mid Y", "Layer", "Rotation"])
        for row in r:
            if row["Ref"] not in fitted:
                continue
            kicad_rot = float(row["Rot"])
            rot = (kicad_rot + rotation_offset(row["Package"])) % 360.0
            dx, dy = position_offset(row["Package"], kicad_rot)
            x = float(row["PosX"]) + dx
            y = float(row["PosY"]) + dy
            w.writerow([row["Ref"], f"{x:.4f}", f"{y:.4f}", "Top", f"{rot:.1f}"])
    print("wrote", out)


if __name__ == "__main__":
    write_bom()
    write_cpl()
