nananek/rp2350-frisk/(commit log)

2026-11-09 Add Pico 2 compatible RP2350A board with 3x USB-C
    [bom_jlcpcb.csv, pico2-compat.kicad_pcb, pico2-compat.kicad_sch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]
2026-11-09 Use 0.3 mm thermal vias to avoid JLCPCB advanced via options
    [pico2-compat.kicad_pcb]
2026-11-09 fix: connect RP2350 DVDD pin 23 and add 4.7uF decoupling
    U1.23 was left unconnected in rev A. Connect it to 1V1 and add C30
    (4.7uF, 0805) 2.56 mm from the pin, matching the RP2350 datasheet's
    DVDD requirement and the Pico 2 reference. Re-place and re-route the
    board, regenerate the fab files and docs, and update the README.
    [bom_jlcpcb.csv, pico2-compat.kicad_pcb, pico2-compat.kicad_sch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]
2026-11-09 feat: make the PIO USB port a Type-C host
    J2 (PIO USB) now sources VBUS and advertises Rp instead of Rd, so
    keyboards and USB memories can be attached. VBUS_PIO is linked to
    VBUS_NATIVE through 0R (R11); D2 and the 1.5k D+ pull-up are removed,
    and the RP2350 internal pull-downs are used for host mode.
    [bom_jlcpcb.csv, pico2-compat.kicad_pcb, pico2-compat.kicad_sch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]
